Stashm10/garage-proximity-sensor/(commit log)

2026-09-29 feat: lateral clearance parking assistant for ESP32
    Portable garage sensor that measures the gap between a car's flank and the
    wall as it drives past, warning via a 5-LED bar and rising-rate beeping.
    Side-facing rather than front-facing: the factory parking sensors already
    cover frontal proximity, but the actual scratches came from lateral
    clearance at the garage entrance.
    Key design points:
    - Tracks minimum clearance during a pass, not just live distance. A wing
    mirror is the tightest point and passes in a fraction of a second.
    - Rolling median-of-3 keeps filter latency at ~20ms (~0.7in of travel at
    2mph); a batch median-of-5 would cost ~125ms and miss the mirror.
    - DHT11 temperature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
    [Button.cpp, Button.h, Presenter.cpp, Presenter.h, Ranger.cpp, Ranger.h, Thermo.cpp, Thermo.h]
2026-09-29 docs: add hardware bench reference
    Complete parts list, power rail separation, and full wiring tables in one
    place. Corrects the LED series resistors from 150 to 100 ohm: the kit
    stocks 100 and 220 but no 150, and brightness is the binding constraint
    since the bar must read from a car seat in a lit garage.
2026-09-29 docs: beginner setup guide, kit-only power options, size analysis
    - GETTING_STARTED.md: what to install, where files live, build order,
    and the common first-time failures (charge-only USB cable, boot mode,
    wrong baud, core 2.x vs 3.x).
    - HARDWARE.md: replace the flat "buy a power bank" note with three
    options, including a fully kit-only 9V + Power Supply Module path.
    Document why 9V straight to VIN destroys the HC-SR04: VIN is the same
    node as USB 5V, not a regulator output.
    - HARDWARE.md: size analysis. Two breadboards end to end are 166x55mm
    against the iPhone 16 Pro Max's 163x77.6mm, but ~30-35mm thick versus
    8.25mm. Breadboard-free requires soldering and parts not in the ki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
2026-09-29 docs: record DevKit V1 silkscreen names for GPIO 16/17
    The board is an ESP32 DevKit V1 (30-pin, USB-C). It prints RX2 and TX2
    rather than D16/D17, so the HC-SR04 wiring instructions were unfollowable
    as written.
2026-09-29 docs: pivot to car-mounted design; record ESP32 breadboard incompatibility
    Design change: the device now rides in the car on the driver's door sill
    with the window lowered, rather than mounting on the garage wall.
    Why: at cabin range the OLED and buzzer actually work, where at garage-wall
    range both were marginal. Calibration becomes permanent since the sensor is
    fixed relative to the car. And it travels, which was the original goal.
    Costs: the window must be down (ultrasonic will not pass through glass),
    and clearance is measured alongside the driver, so a front corner swinging
    wide on a turn-in is not directly covered.
    Power simplifies to the car's USB port - no bank, no 9V, no runtime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
